snickerdude/MSD4thAxis/FourthAxis/ControlBoard.step

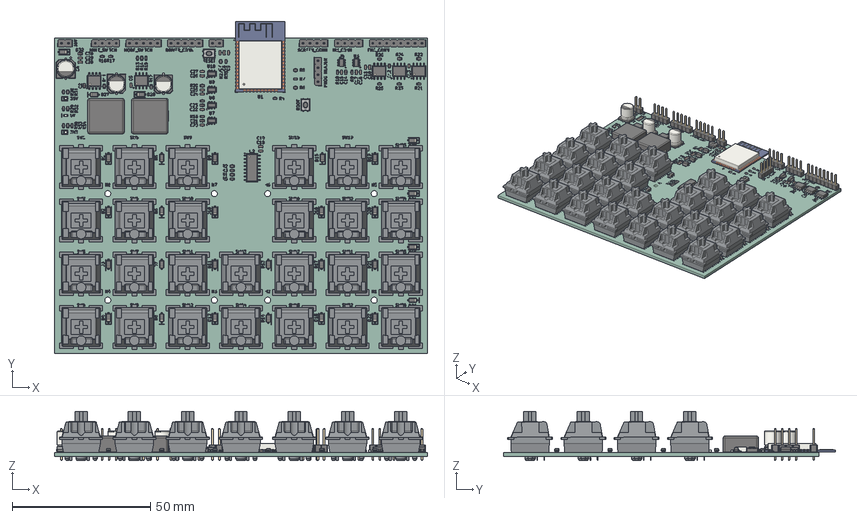
[picture p1: CAD file, 2026-09-14]
FourthAxis/ControlBoard.step
135.1 x 120.3 x 17.9 mm
D_SOD-123 x 29
C_0603_1608Metric x 26
RK61 - Cherry MX Switch x 26
R_0603_1608Metric x 35
PinHeader_1x04_P2.54mm_Vertical x 4
L_APV_APH1260 x 2
LED_0603_1608Metric x 3
PinHeader_1x05_P2.54mm_Vertical x 2
SOIC-8_3.9x4.9mm_P1.27mm x 5
PinHeader_1x02_P2.54mm_Vertical x 2
CP_Elec_6.3x7.7 x 3
SOIC-16_3.9x9.9mm_P1.27mm
SOT-23-6 x 6
SW_Push_1P1T_NO_CK_KMR2 x 2
PinHeader_1x08_P2.54mm_Vertical
ESP32-WROOM-32
FourthAxis_silkscreen x 2
FourthAxis_PCB
