snickerdude/MSD4thAxis/FourthAxis/RK61 - Cherry MX Switch.step

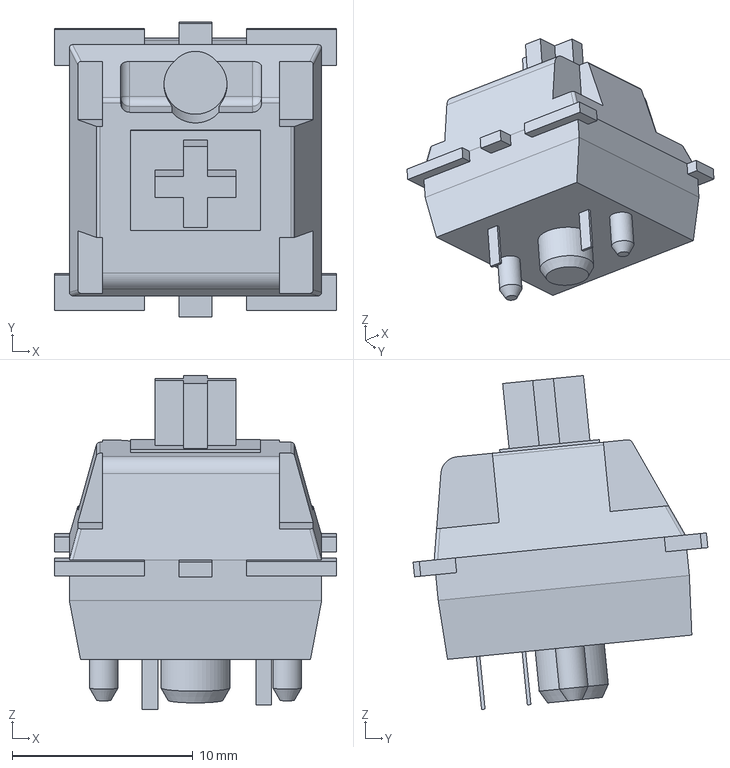
[picture p2: CAD file, 2026-04-06]
FourthAxis/RK61 - Cherry MX Switch.step
15.6 x 16.3 x 18.5 mm
