snickerdude/MSD4thAxis/(list of files, cad)

Other CAD files:
FourthAxis/Cherry MX Switch.step
