snickerdude/MSD4thAxis/FourthAxis/FourthAxis.kicad_pcb

## KiCad design FourthAxis/FourthAxis.kicad_pcb (2026-08-26)

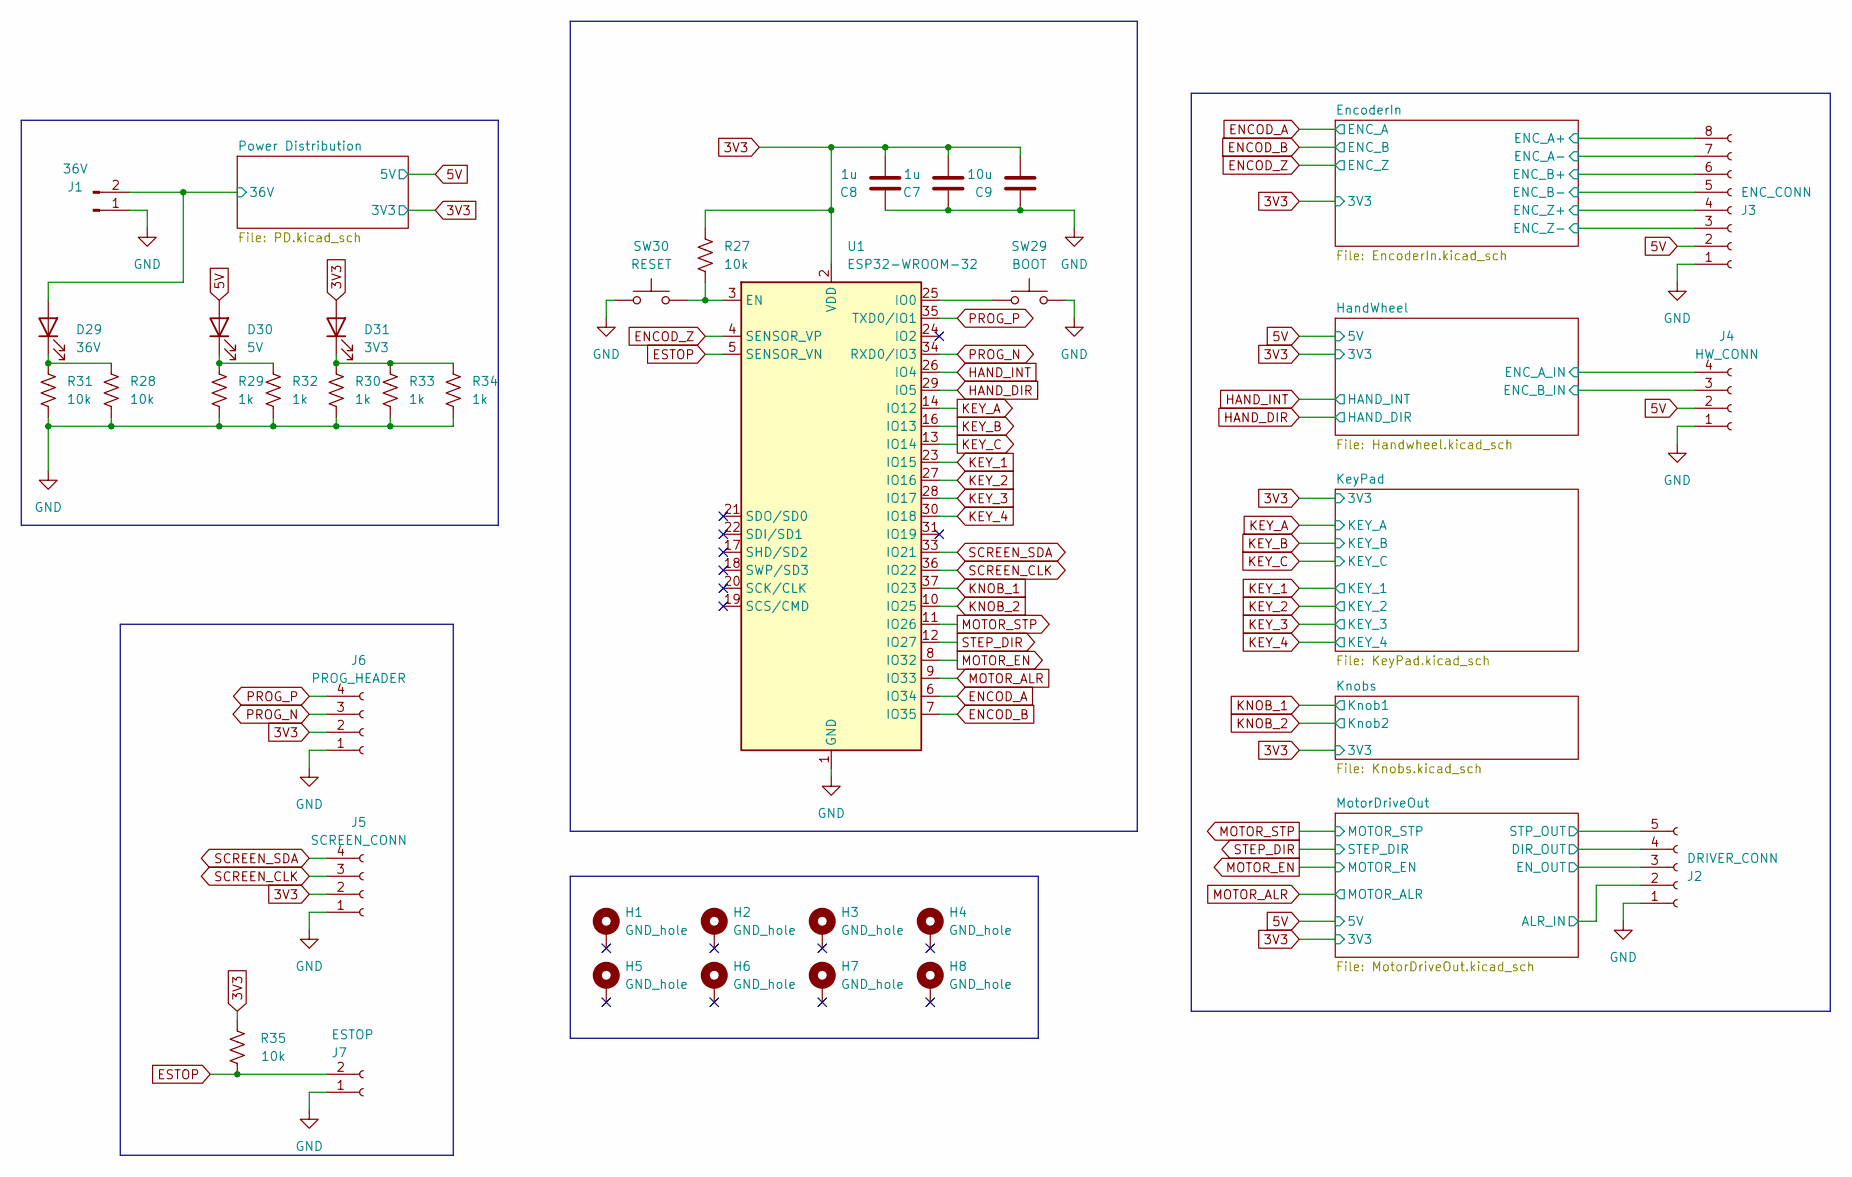
[picture p3: schematic FourthAxis.kicad_sch]

Parts:
C7, C8: 1u; C_0603_1608Metric; digikey 1276-1184-1-ND
C9: 10u; C_0603_1608Metric; digikey 1292-0603X106M100CT-ND
D29: 36V; LED_0603_1608Metric; digikey 160-1182-1-ND
D30: 5V; LED_0603_1608Metric; digikey 160-1182-1-ND
D31: 3V3; LED_0603_1608Metric; digikey 160-1182-1-ND
H1, H2, H3, H4, H5, H6, H7, H8: GND_hole; MountingHole_2.2mm_M2_Pad
J1: 36V; PinHeader_1x02_P2.54mm_Vertical
J2: DRIVER_CONN; PinHeader_1x05_P2.54mm_Vertical
J3: ENC_CONN; PinHeader_1x08_P2.54mm_Vertical
J4: HW_CONN; PinHeader_1x04_P2.54mm_Vertical
J5: SCREEN_CONN; PinHeader_1x04_P2.54mm_Vertical
J6: PROG_HEADER; PinHeader_1x04_P2.54mm_Vertical
J7: ESTOP; PinHeader_1x02_P2.54mm_Vertical
R27, R28, R31, R35: 10k; R_0603_1608Metric; digikey 311-10.0KHRCT-ND
R29, R30, R32, R33, R34: 1k; R_0603_1608Metric; digikey 311-1.00KHRCT-ND
SW29: BOOT; SW_Push_1P1T_NO_CK_KMR2; digikey CKN10284CT-ND
SW30: RESET; SW_Push_1P1T_NO_CK_KMR2; digikey CKN10284CT-ND
U1: ESP32-WROOM-32; Digikey Part Number 1965-ESP32-WROOM-32E-N4CT-ND

Connections:
3V3: C7.2, C8.2, C9.2, D31.2 (A), J5.2, J6.2, R27.1, R35.1, U1.2 (VDD); also elsewhere on the board
5V: D30.2 (A), J3.2, J4.2; also elsewhere on the board
/EncoderIn/ENC_A+: J3.8; also elsewhere on the board
/EncoderIn/ENC_A-: J3.7; also elsewhere on the board
/EncoderIn/ENC_B+: J3.6; also elsewhere on the board
/EncoderIn/ENC_B-: J3.5; also elsewhere on the board
/EncoderIn/ENC_Z+: J3.4; also elsewhere on the board
/EncoderIn/ENC_Z-: J3.3; also elsewhere on the board
/HandWheel/ENC_A_IN: J4.4; also elsewhere on the board
/HandWheel/ENC_B_IN: J4.3; also elsewhere on the board
/MotorDriveOut/ALR_IN: J2.2; also elsewhere on the board
/MotorDriveOut/DIR_OUT: J2.4; also elsewhere on the board
/MotorDriveOut/EN_OUT: J2.3; also elsewhere on the board
/MotorDriveOut/STP_OUT: J2.5; also elsewhere on the board
/Power Distribution/36V: D29.2 (A), J1.2; also elsewhere on the board
ENCOD_A: U1.6 (IO34); also elsewhere on the board
ENCOD_B: U1.7 (IO35); also elsewhere on the board
ENCOD_Z: U1.4 (SENSOR_VP); also elsewhere on the board
ESTOP: J7.2, R35.2, U1.5 (SENSOR_VN)
GND: C7.1, C8.1, C9.1, J1.1, J2.1, J3.1, J4.1, J5.1, J6.1, J7.1, R28.2, R29.2, R30.2, R31.2, R32.2, R33.2, R34.2, SW29.2, SW30.2, U1.1 (GND), U1.15 (GND), U1.38 (GND), U1.39 (GND); also elsewhere on the board
HAND_DIR: U1.29 (IO5); also elsewhere on the board
HAND_INT: U1.26 (IO4); also elsewhere on the board
KEY_1: U1.23 (IO15); also elsewhere on the board
KEY_2: U1.27 (IO16); also elsewhere on the board
KEY_3: U1.28 (IO17); also elsewhere on the board
KEY_4: U1.30 (IO18); also elsewhere on the board
KEY_A: U1.14 (IO12); also elsewhere on the board
KEY_B: U1.16 (IO13); also elsewhere on the board
KEY_C: U1.13 (IO14); also elsewhere on the board
KNOB_1: U1.37 (IO23); also elsewhere on the board
KNOB_2: U1.10 (IO25); also elsewhere on the board
MOTOR_ALR: U1.9 (IO33); also elsewhere on the board
MOTOR_EN: U1.8 (IO32); also elsewhere on the board
MOTOR_STP: U1.11 (IO26); also elsewhere on the board
unnamed: D29.1 (K), R28.1, R31.1
unnamed: D30.1 (K), R29.1, R32.1
unnamed: D31.1 (K), R30.1, R33.1, R34.1
unnamed: R27.2, SW30.1, U1.3 (EN)
unnamed: SW29.1, U1.25 (IO0)
PROG_N: J6.3, U1.34 (RXD0/IO3)
PROG_P: J6.4, U1.35 (TXD0/IO1)
SCREEN_CLK: J5.3, U1.36 (IO22)
SCREEN_SDA: J5.4, U1.33 (IO21)
STEP_DIR: U1.12 (IO27); also elsewhere on the board

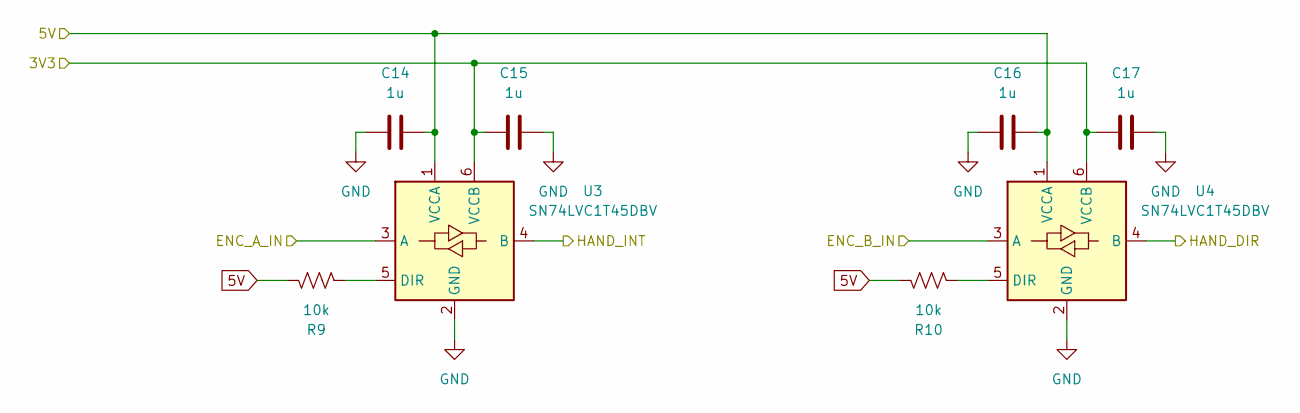
[picture p4: schematic Handwheel.kicad_sch]

Parts:
C14, C15, C16, C17: 1u; C_0603_1608Metric; digikey 1276-1184-1-ND
R9, R10: 10k; R_0603_1608Metric; digikey 311-10.0KHRCT-ND
U3, U4: SN74LVC1T45DBV; SOT-23-6; digikey 296-16843-1-ND

Connections:
3V3: C15.2, C17.2, U3.6 (VCCB), U4.6 (VCCB); also elsewhere on the board
5V: C14.1, C16.1, R9.1, R10.1, U3.1 (VCCA), U4.1 (VCCA); also elsewhere on the board
/HandWheel/ENC_A_IN: U3.3 (A); also elsewhere on the board
/HandWheel/ENC_B_IN: U4.3 (A); also elsewhere on the board
GND: C14.2, C15.1, C16.2, C17.1, U3.2 (GND), U4.2 (GND); also elsewhere on the board
HAND_DIR: U4.4 (B); also elsewhere on the board
HAND_INT: U3.4 (B); also elsewhere on the board
unnamed: R9.2, U3.5 (DIR)
unnamed: R10.2, U4.5 (DIR)

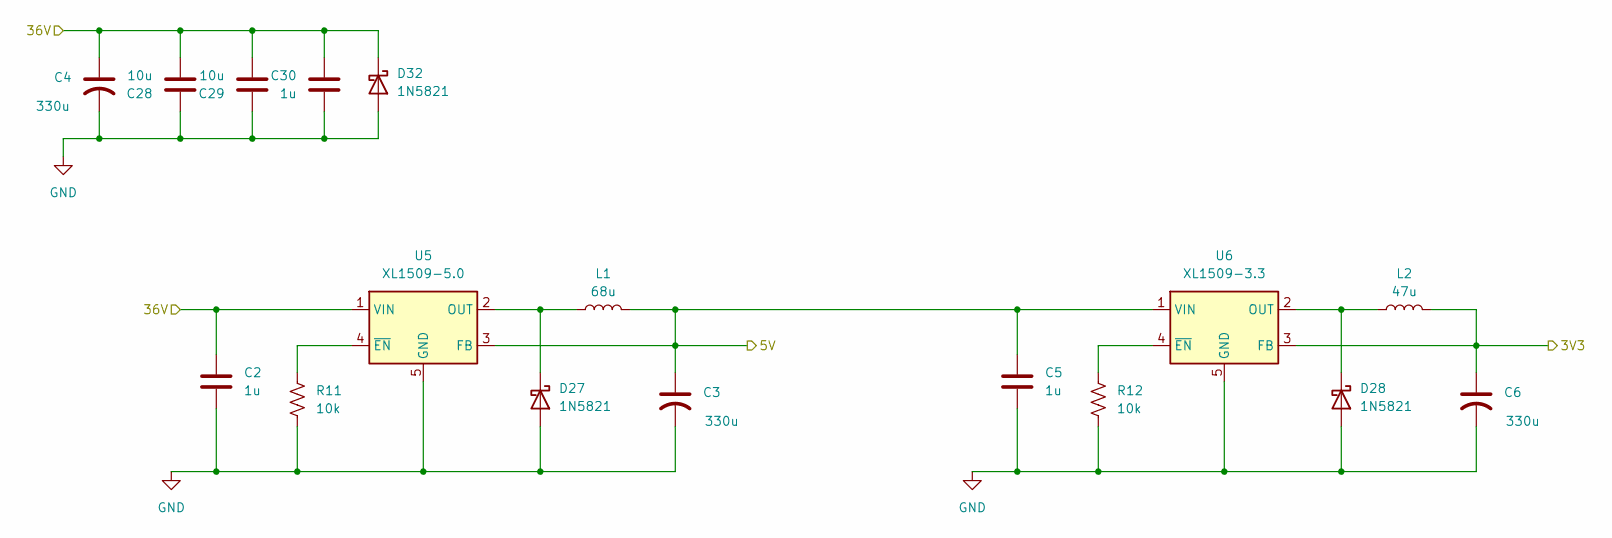
[picture p5: schematic PD.kicad_sch]

Parts:
C2, C5, C30: 1u; C_0603_1608Metric; digikey 1276-1184-1-ND
C3, C4, C6: 330u; CP_Elec_6.3x7.7; digikey 493-2157-1-ND
C28, C29: 10u; C_0603_1608Metric; digikey 1292-0603X106M100CT-ND
D27, D28, D32: 1N5821; D_SOD-123; digikey 641-1458-1-ND
L1: 68u; L_12x12mm_H6mm; digikey 399-MPXV1D1250L680CT-ND
L2: 47u; L_12x12mm_H6mm; digikey 399-MPXV1D1250L470CT-ND
R11, R12: 10k; R_0603_1608Metric; digikey 311-10.0KHRCT-ND
U5: XL1509-5.0; SOIC-8_3.9x4.9mm_P1.27mm; digikey 4518-XL1509-5.0CT-ND
U6: XL1509-3.3; SOIC-8_3.9x4.9mm_P1.27mm; digikey 4518-XL1509-3.3CT-ND

Connections:
3V3: C6.1, L2.2, U6.3 (FB); also elsewhere on the board
5V: C3.1, C5.1, L1.2, U5.3 (FB), U6.1 (VIN); also elsewhere on the board
/Power Distribution/36V: C2.1, C4.1, C28.2, C29.2, C30.1, D32.1 (K), U5.1 (VIN); also elsewhere on the board
GND: C2.2, C3.2, C4.2, C5.2, C6.2, C28.1, C29.1, C30.2, D27.2 (A), D28.2 (A), D32.2 (A), R11.2, R12.2, U5.5 (GND), U5.6 (GND), U5.7 (GND), U5.8 (GND), U6.5 (GND), U6.6 (GND), U6.7 (GND), U6.8 (GND); also elsewhere on the board
unnamed: D27.1 (K), L1.1, U5.2 (OUT)
unnamed: D28.1 (K), L2.1, U6.2 (OUT)
unnamed: R11.1, U5.4 (~EN)
unnamed: R12.1, U6.4 (~EN)

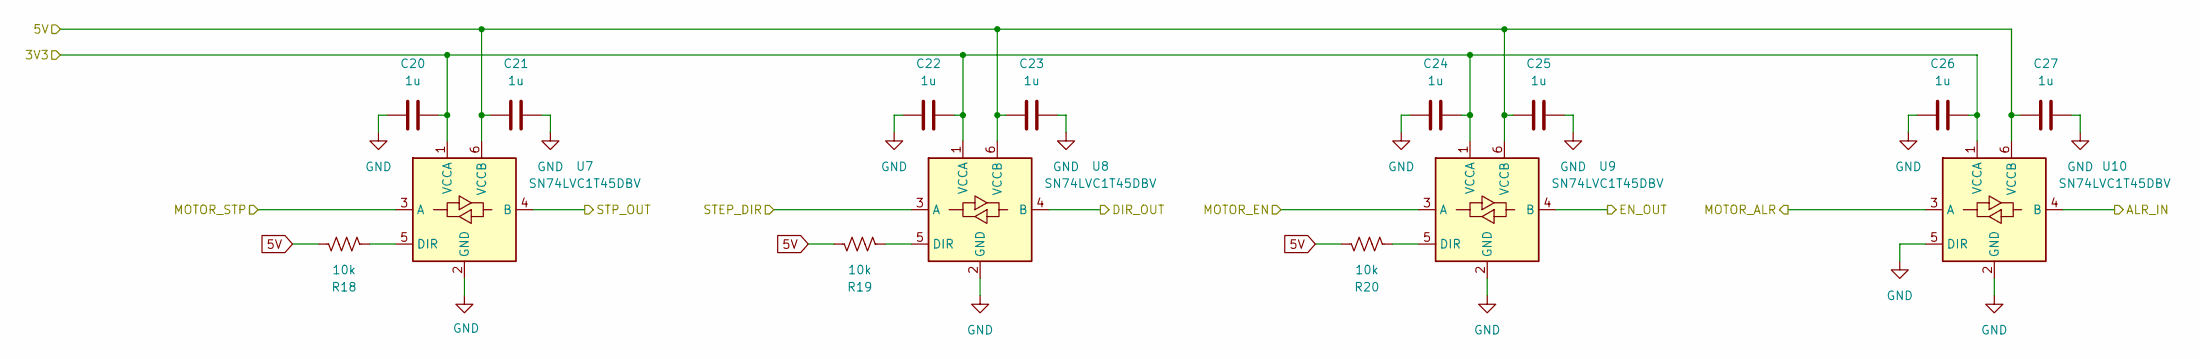
[picture p6: schematic MotorDriveOut.kicad_sch]

Parts:
C20, C21, C22, C23, C24, C25, C26, C27: 1u; C_0603_1608Metric; digikey 1276-1184-1-ND
R18, R19, R20: 10k; R_0603_1608Metric; digikey 311-10.0KHRCT-ND
U7, U8, U9, U10: SN74LVC1T45DBV; SOT-23-6; digikey 296-16843-1-ND

Connections:
3V3: C20.1, C22.1, C24.1, C26.1, U7.1 (VCCA), U8.1 (VCCA), U9.1 (VCCA), U10.1 (VCCA); also elsewhere on the board
5V: C21.2, C23.2, C25.2, C27.2, R18.1, R19.1, R20.1, U7.6 (VCCB), U8.6 (VCCB), U9.6 (VCCB), U10.6 (VCCB); also elsewhere on the board
/MotorDriveOut/ALR_IN: U10.4 (B); also elsewhere on the board
/MotorDriveOut/DIR_OUT: U8.4 (B); also elsewhere on the board
/MotorDriveOut/EN_OUT: U9.4 (B); also elsewhere on the board
/MotorDriveOut/STP_OUT: U7.4 (B); also elsewhere on the board
GND: C20.2, C21.1, C22.2, C23.1, C24.2, C25.1, C26.2, C27.1, U7.2 (GND), U8.2 (GND), U9.2 (GND), U10.2 (GND), U10.5 (DIR); also elsewhere on the board
MOTOR_ALR: U10.3 (A); also elsewhere on the board
MOTOR_EN: U9.3 (A); also elsewhere on the board
MOTOR_STP: U7.3 (A); also elsewhere on the board
unnamed: R18.2, U7.5 (DIR)
unnamed: R19.2, U8.5 (DIR)
unnamed: R20.2, U9.5 (DIR)
STEP_DIR: U8.3 (A); also elsewhere on the board

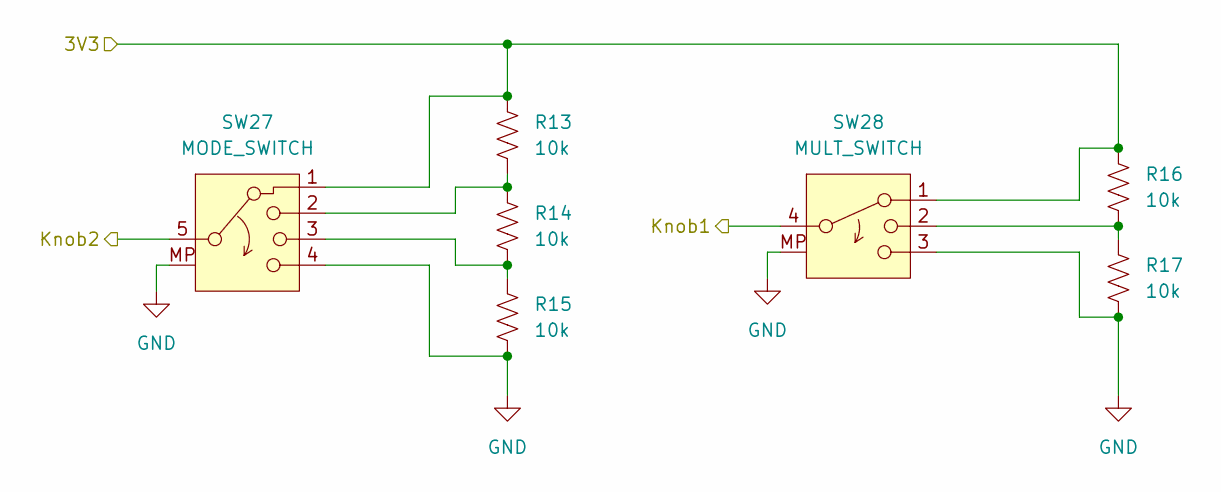
[picture p7: schematic Knobs.kicad_sch]

Parts:
R13, R14, R15, R16, R17: 10k; R_0603_1608Metric; digikey 311-10.0KHRCT-ND
SW27: MODE_SWITCH; PinHeader_1x05_P2.54mm_Vertical
SW28: MULT_SWITCH; PinHeader_1x04_P2.54mm_Vertical

Connections:
3V3: R13.1, R16.1, SW27.1, SW28.1; also elsewhere on the board
GND: R15.2, R17.2, SW27.4, SW27.MP, SW28.3, SW28.MP; also elsewhere on the board
KNOB_1: SW28.4; also elsewhere on the board
KNOB_2: SW27.5; also elsewhere on the board
unnamed: R13.2, R14.1, SW27.2
unnamed: R14.2, R15.1, SW27.3
unnamed: R16.2, R17.1, SW28.2

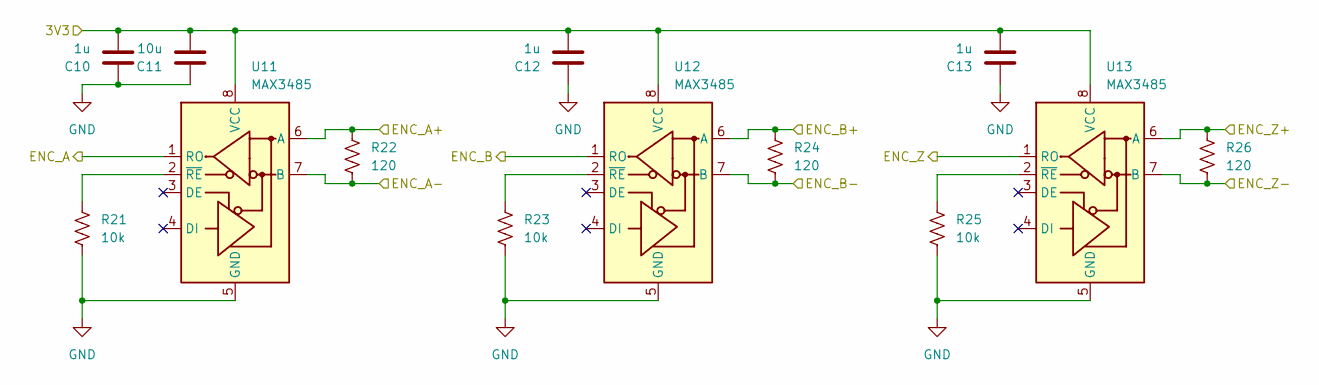
[picture p8: schematic EncoderIn.kicad_sch]

Parts:
C10, C12, C13: 1u; C_0603_1608Metric; digikey 1276-1184-1-ND
C11: 10u; C_0603_1608Metric; digikey 1292-0603X106M100CT-ND
R21, R23, R25: 10k; R_0603_1608Metric; digikey 311-10.0KHRCT-ND
R22, R24, R26: 120; R_0603_1608Metric; digikey 541-10426-1-ND
U11, U12, U13: MAX3485; SOIC-8_3.9x4.9mm_P1.27mm; digikey 5272-MAX3485ESA-EVCT-ND

Connections:
3V3: C10.2, C11.2, C12.2, C13.2, U11.8 (VCC), U12.8 (VCC), U13.8 (VCC); also elsewhere on the board
/EncoderIn/ENC_A+: R22.2, U11.6 (A); also elsewhere on the board
/EncoderIn/ENC_A-: R22.1, U11.7 (B); also elsewhere on the board
/EncoderIn/ENC_B+: R24.2, U12.6 (A); also elsewhere on the board
/EncoderIn/ENC_B-: R24.1, U12.7 (B); also elsewhere on the board
/EncoderIn/ENC_Z+: R26.2, U13.6 (A); also elsewhere on the board
/EncoderIn/ENC_Z-: R26.1, U13.7 (B); also elsewhere on the board
ENCOD_A: U11.1 (RO); also elsewhere on the board
ENCOD_B: U12.1 (RO); also elsewhere on the board
ENCOD_Z: U13.1 (RO); also elsewhere on the board
GND: C10.1, C11.1, C12.1, C13.1, R21.2, R23.2, R25.2, U11.5 (GND), U12.5 (GND), U13.5 (GND); also elsewhere on the board
unnamed: R21.1, U11.2 (~RE)
unnamed: R23.1, U12.2 (~RE)
unnamed: R25.1, U13.2 (~RE)

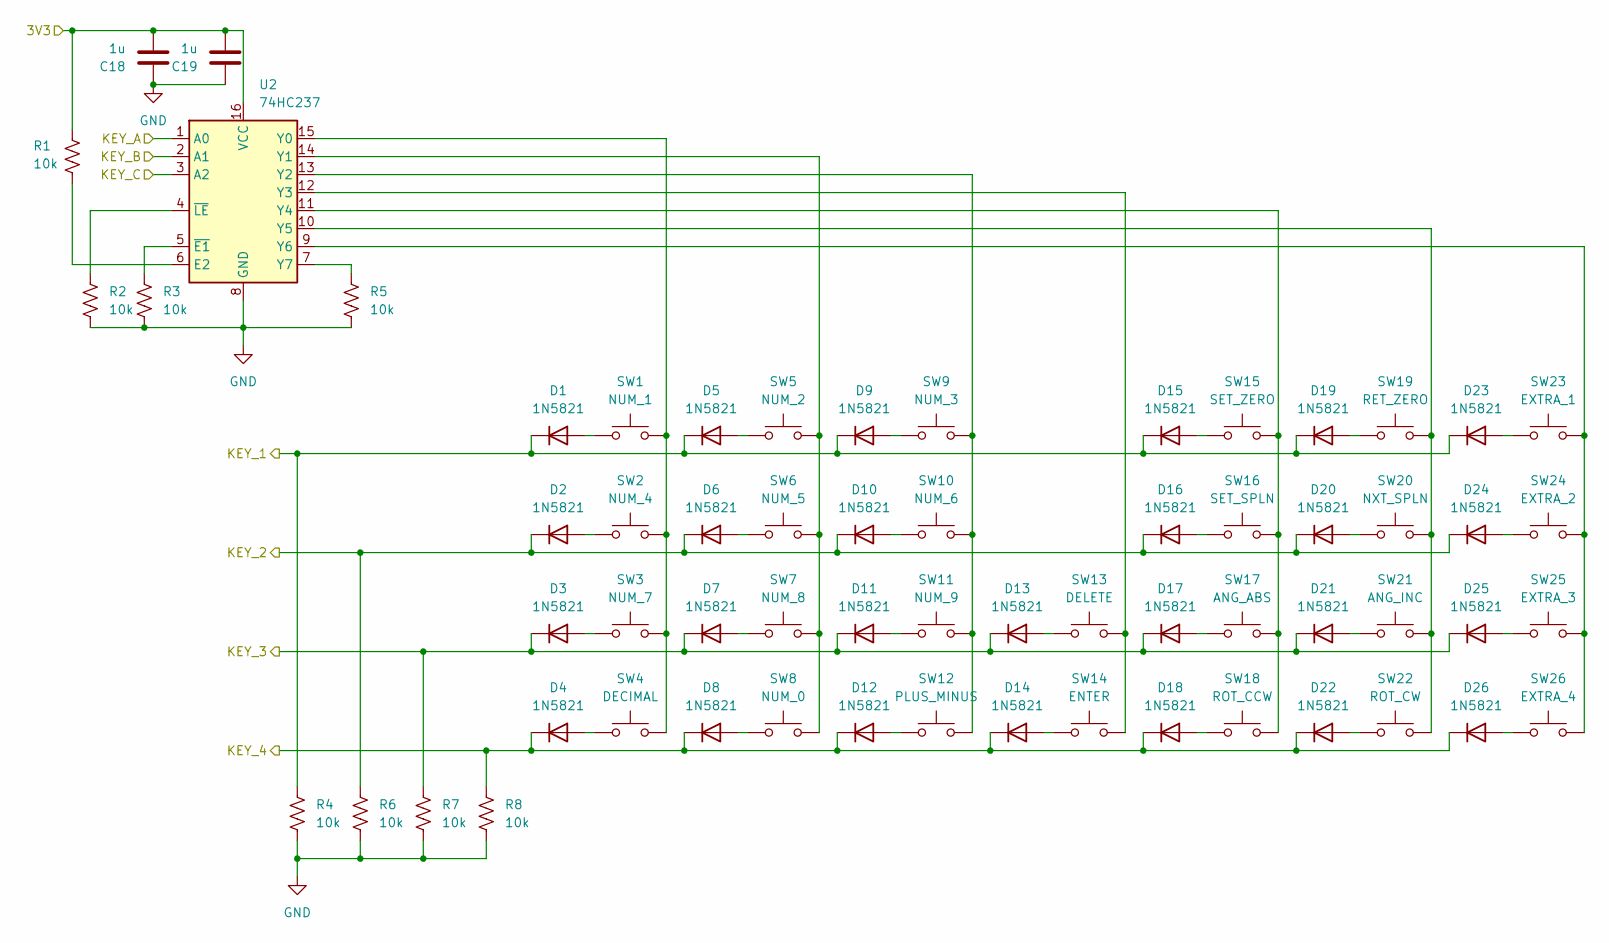
[picture p9: schematic KeyPad.kicad_sch]

Parts:
C18, C19: 1u; C_0603_1608Metric; digikey 1276-1184-1-ND
D1, D2, D3, D4, D5, D6, D7, D8, D9, D10, D11, D12, D13, D14, D15, D16, D17, D18, D19, D20, D21, D22, D23, D24, D25, D26: 1N5821; D_SOD-123; digikey 641-1458-1-ND
R1, R2, R3, R4, R5, R6, R7, R8: 10k; R_0603_1608Metric; digikey 311-10.0KHRCT-ND
SW1: NUM_1; SW_Cherry_MX_1.00u_PCB
SW2: NUM_4; SW_Cherry_MX_1.00u_PCB
SW3: NUM_7; SW_Cherry_MX_1.00u_PCB
SW4: DECIMAL; SW_Cherry_MX_1.00u_PCB
SW5: NUM_2; SW_Cherry_MX_1.00u_PCB
SW6: NUM_5; SW_Cherry_MX_1.00u_PCB
SW7: NUM_8; SW_Cherry_MX_1.00u_PCB
SW8: NUM_0; SW_Cherry_MX_1.00u_PCB
SW9: NUM_3; SW_Cherry_MX_1.00u_PCB
SW10: NUM_6; SW_Cherry_MX_1.00u_PCB
SW11: NUM_9; SW_Cherry_MX_1.00u_PCB
SW12: PLUS_MINUS; SW_Cherry_MX_1.00u_PCB
SW13: DELETE; SW_Cherry_MX_1.00u_PCB
SW14: ENTER; SW_Cherry_MX_1.00u_PCB
SW15: SET_ZERO; SW_Cherry_MX_1.00u_PCB
SW16: SET_SPLN; SW_Cherry_MX_1.00u_PCB
SW17: ANG_ABS; SW_Cherry_MX_1.00u_PCB
SW18: ROT_CCW; SW_Cherry_MX_1.00u_PCB
SW19: RET_ZERO; SW_Cherry_MX_1.00u_PCB
SW20: NXT_SPLN; SW_Cherry_MX_1.00u_PCB
SW21: ANG_INC; SW_Cherry_MX_1.00u_PCB
SW22: ROT_CW; SW_Cherry_MX_1.00u_PCB
SW23: EXTRA_1; SW_Cherry_MX_1.00u_PCB
SW24: EXTRA_2; SW_Cherry_MX_1.00u_PCB
SW25: EXTRA_3; SW_Cherry_MX_1.00u_PCB
SW26: EXTRA_4; SW_Cherry_MX_1.00u_PCB
U2: 74HC237; SOIC-16_3.9x9.9mm_P1.27mm; Digikey Part Number 74HC237DCT-ND

Connections:
3V3: C18.2, C19.2, R1.1, U2.16 (VCC); also elsewhere on the board
GND: C18.1, C19.1, R2.2, R3.2, R4.2, R5.2, R6.2, R7.2, R8.2, U2.8 (GND); also elsewhere on the board
KEY_1: D1.1 (K), D5.1 (K), D9.1 (K), D15.1 (K), D19.1 (K), D23.1 (K), R4.1; also elsewhere on the board
KEY_2: D2.1 (K), D6.1 (K), D10.1 (K), D16.1 (K), D20.1 (K), D24.1 (K), R6.1; also elsewhere on the board
KEY_3: D3.1 (K), D7.1 (K), D11.1 (K), D13.1 (K), D17.1 (K), D21.1 (K), D25.1 (K), R7.1; also elsewhere on the board
KEY_4: D4.1 (K), D8.1 (K), D12.1 (K), D14.1 (K), D18.1 (K), D22.1 (K), D26.1 (K), R8.1; also elsewhere on the board
KEY_A: U2.1 (A0); also elsewhere on the board
KEY_B: U2.2 (A1); also elsewhere on the board
KEY_C: U2.3 (A2); also elsewhere on the board
unnamed: D1.2 (A), SW1.1
unnamed: D2.2 (A), SW2.1
unnamed: D3.2 (A), SW3.1
unnamed: D4.2 (A), SW4.1
unnamed: D5.2 (A), SW5.1
unnamed: D6.2 (A), SW6.1
unnamed: D7.2 (A), SW7.1
unnamed: D8.2 (A), SW8.1
unnamed: D9.2 (A), SW9.1
unnamed: D10.2 (A), SW10.1
unnamed: D11.2 (A), SW11.1
unnamed: D12.2 (A), SW12.1
unnamed: D13.2 (A), SW13.1
unnamed: D14.2 (A), SW14.1
unnamed: D15.2 (A), SW15.1
unnamed: D16.2 (A), SW16.1
unnamed: D17.2 (A), SW17.1
unnamed: D18.2 (A), SW18.1
unnamed: D19.2 (A), SW19.1
unnamed: D20.2 (A), SW20.1
unnamed: D21.2 (A), SW21.1
unnamed: D22.2 (A), SW22.1
unnamed: D23.2 (A), SW23.1
unnamed: D24.2 (A), SW24.1
unnamed: D25.2 (A), SW25.1
unnamed: D26.2 (A), SW26.1
unnamed: R1.2, U2.6 (E2)
unnamed: SW1.2, SW2.2, SW3.2, SW4.2, U2.15 (Y0)
unnamed: SW5.2, SW6.2, SW7.2, SW8.2, U2.14 (Y1)
unnamed: SW9.2, SW10.2, SW11.2, SW12.2, U2.13 (Y2)
unnamed: SW13.2, SW14.2, U2.12 (Y3)
unnamed: SW15.2, SW16.2, SW17.2, SW18.2, U2.11 (Y4)
unnamed: SW19.2, SW20.2, SW21.2, SW22.2, U2.10 (Y5)
unnamed: SW23.2, SW24.2, SW25.2, SW26.2, U2.9 (Y6)
unnamed: R5.1, U2.7 (Y7)
unnamed: R3.1, U2.5 (~E1)
unnamed: R2.1, U2.4 (~LE)

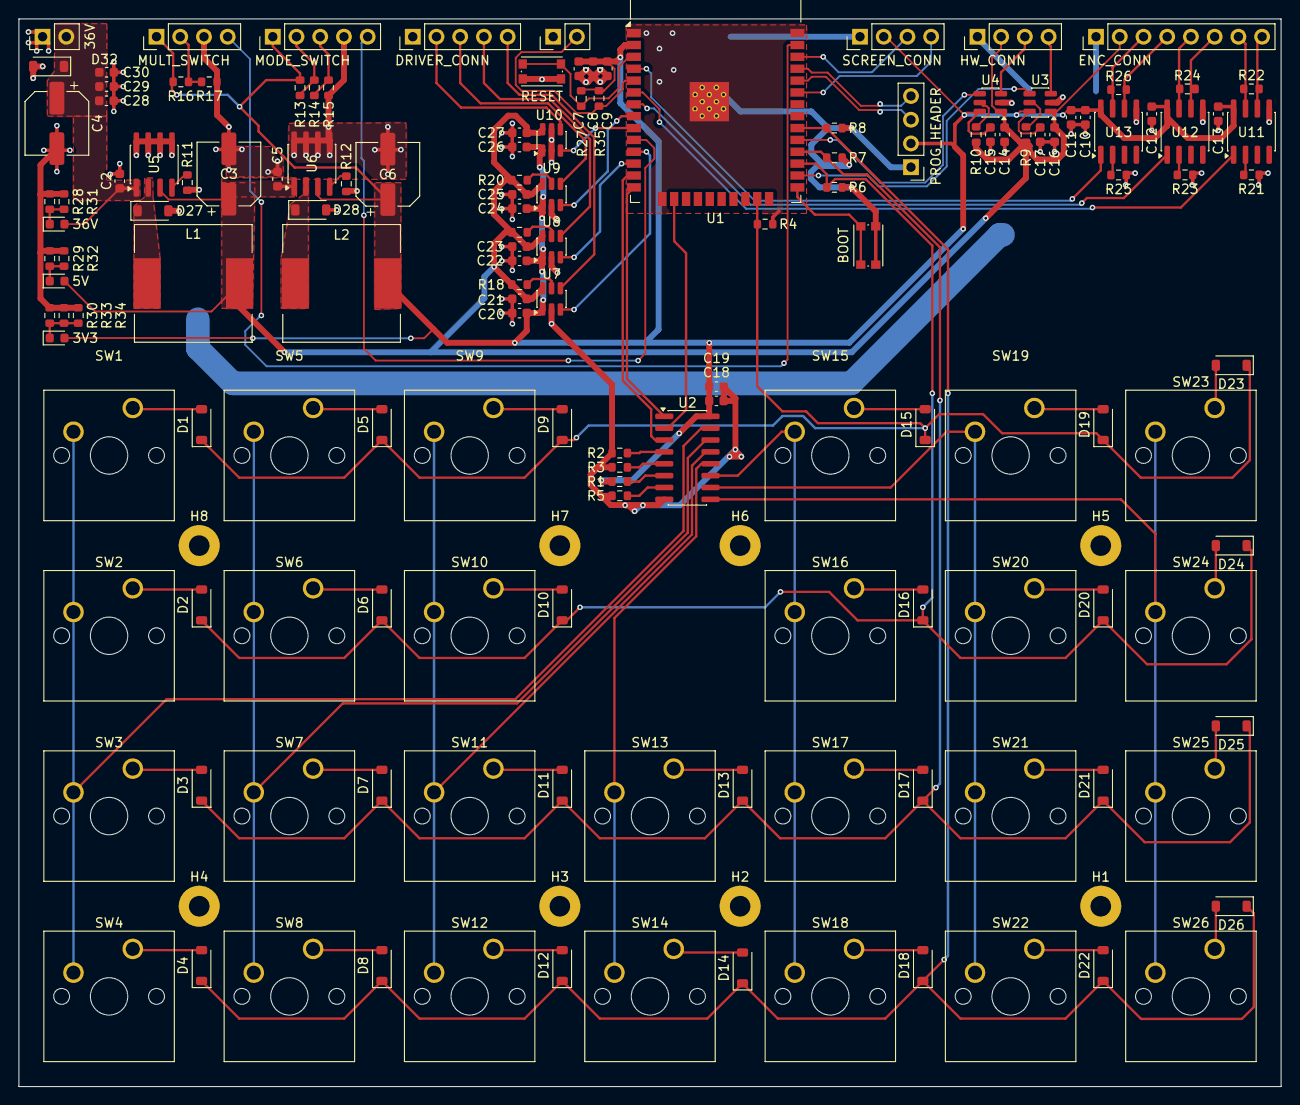
[picture p10: board FourthAxis.kicad_pcb from above]

Board: 2 copper layers, 135.1 x 114.3 mm, 156 parts (0 on the bottom side), 96 nets.
