snickerdude/MSD4thAxis/(commit log)

2026-03-25 initial ESP32 pinout
    [FourthAxis.kicad_pcb, FourthAxis.kicad_sch]
2026-03-26 Laptop close
    [FourthAxis.kicad_sch]
2026-04-01 Progress save
    [FourthAxis.kicad_pcb, FourthAxis.kicad_sch, KeyPad.kicad_sch]
2026-04-01 Added handwheel sheet
    [FourthAxis.kicad_sch, Handwheel.kicad_sch, KeyPad.kicad_sch]
2026-04-02 Added PD sheet
    [FourthAxis.kicad_sch, PD.kicad_sch]
2026-04-02 Added PD symbols
    [PD.kicad_sch]
2026-04-06 Keypad schem work
    [FourthAxis.kicad_pcb, FourthAxis.kicad_sch, Handwheel.kicad_sch, KeyPad.kicad_sch, PD.kicad_sch]
2026-04-06 fixing commit
    [Handwheel.kicad_sch]
2026-04-06 key model added
    [FourthAxis.kicad_pcb]
2026-04-06 schem changes
    [PD.kicad_sch]
2026-04-07 started handwheel
    [FourthAxis.kicad_sch, Handwheel.kicad_sch]
2026-04-08 schem additions
    [FourthAxis.kicad_sch, Handwheel.kicad_sch, KeyPad.kicad_sch, Knobs.kicad_sch]
2026-04-08 name and layout
    [FourthAxis.kicad_pcb, Handwheel.kicad_sch, KeyPad.kicad_sch, Knobs.kicad_sch]
2026-04-08 Shaun work
    [FourthAxis.kicad_sch, PD.kicad_sch]
2026-04-08 shaun today
    [FourthAxis.kicad_sch, PD.kicad_sch]
2026-04-08 Nick end of wed
    [EncoderOut.kicad_sch, FourthAxis.kicad_sch, Handwheel.kicad_sch, Knobs.kicad_sch]
2026-04-08 shaun add
    [FourthAxis.kicad_sch]
2026-04-13 Name changes
    [EncoderIn.kicad_sch, FourthAxis.kicad_sch, MotorDriveOut.kicad_sch]
2026-04-13 Encoder input added?
    [EncoderIn.kicad_sch, FourthAxis.kicad_sch, PD.kicad_sch]
2026-04-20 digikey PN and footprints
    [EncoderIn.kicad_sch, FourthAxis.kicad_pcb, FourthAxis.kicad_sch, Handwheel.kicad_sch, KeyPad.kicad_sch, Knobs.kicad_sch, MotorDriveOut.kicad_sch, PD.kicad_sch]
2026-04-22 Layout work
    [FourthAxis.kicad_pcb, FourthAxis.kicad_sch, Knobs.kicad_sch]
2026-05-16 Layout work, added power LEDs
    [FourthAxis.kicad_pcb]
2026-05-29 started routing
    [FourthAxis.kicad_pcb, FourthAxis.kicad_sch, Handwheel.kicad_sch, MotorDriveOut.kicad_sch]
2026-05-30 traces almost complete
    [FourthAxis.kicad_pcb, FourthAxis.kicad_sch]
2026-06-06 Generated Fab Files
    [FourthAxis-B_Cu.gbr, FourthAxis-B_Mask.gbr, FourthAxis-B_Paste.gbr, FourthAxis-B_Silkscreen.gbr, FourthAxis-Edge_Cuts.gbr, FourthAxis-F_Cu.gbr, FourthAxis-F_Mask.gbr, FourthAxis-F_Paste.gbr]
2026-06-06 BOM export
    [FourthAxis.csv, FourthAxis.kicad_sch, KeyPad.kicad_sch, Knobs.kicad_sch]
2026-06-23 boards ordered
    [EncoderIn.kicad_sch, FourthAxis.kicad_sch, KeyPad.kicad_sch, PD.kicad_sch]
2026-07-22 started encoder drivers
2026-07-28 working out encoder bugs
    [FourthAxisCode.ino, encoder.cpp, encoder.h]
2026-08-10 Display drivers starter
2026-08-26 please work
    [FourthAxis.kicad_pcb]
2026-10-26 stepper spins!
2026-10-26 thread implemented
